DeDiamondPro/AQLARP/README.md

# AQLARP
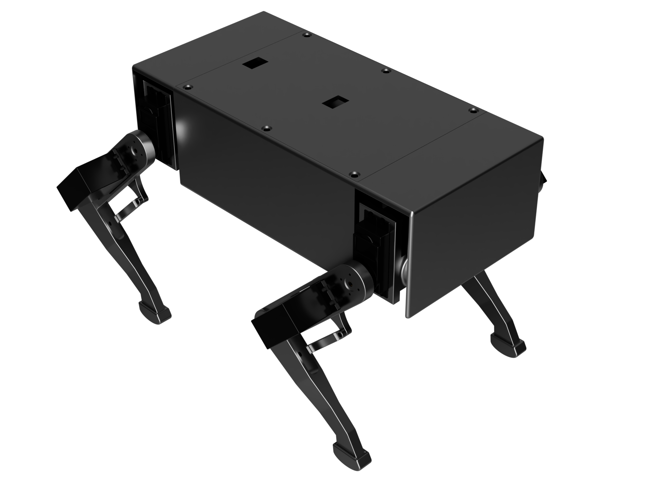
[picture p1: documentation/src/img/AQLARP-render-transparent.png]


AQLARP stands for **A**ffordable **Q**uadruped **L**earning **A**nd **R**esearch **P**latform.

AQLARP was created as my final project for high school.

For more information please see the [documentation](https://aqlarp.dediamondpro.dev)

## AQLARP Walking Demo:

(https://www.youtube.com/watch?v=xvpN8pladkQ)
