DeDiamondPro/AQLARP/documentation/src/ch08-00-inverse-kinematics.md

# Inverse Kinematics
In this chapter we will look at the calculations behind the inverse kinematics of AQLARP. These calculations are based on trigonometry since it is quite easy to split all these problems into triangles.
If you are not familiar with this topic or want more info, I would recommend watching the video below as it does a great job explaining this concept in a simple manner.
<iframe width="560" height="315" src="https://www.youtube-nocookie.com/embed/IN8tjTk8ExI?si=d5JtWDZTZR-PFiA2&amp;start=295" title="YouTube video player" frameborder="0" allow="accelerometer; autoplay; clipboard-write; encrypted-media; gyroscope; picture-in-picture; web-share" allowfullscreen></iframe>
