DeDiamondPro/AQLARP/documentation/src/title-page.md

# AQLARP


Welcome to the AQLARP documentation. This documentation is built with [mdBook](https://github.com/rust-lang/mdBook)

AQLARP stands for **A**ffordable **Q**uadruped **L**earning **A**nd **R**esearch **P**latform.

AQLARP is licensed under the [MIT license](https://github.com/DeDiamondPro/AQLARP/blob/master/LICENSE).

AQLARP was created as my final project for high school.

> **🚨 This documentation might be incomplete**
>
> It is advisable to have a basic understanding of the parts of the robot to effectively address encountered issues. If you need help, feel free to open an issue on [AQLARP's GitHub](https://github.com/DeDiamondPro/AQLARP). However there is no guarantee that I will be able to help you.

<iframe width="560" height="315" src="https://www.youtube-nocookie.com/embed/xvpN8pladkQ?si=OSj0AorqTDjWEt1B" title="YouTube video player" frameborder="0" allow="accelerometer; autoplay; clipboard-write; encrypted-media; gyroscope; picture-in-picture; web-share" allowfullscreen></iframe>
