DeDiamondPro/AQLARP/documentation/src/SUMMARY.md

# AQLARP

[AQLARP](title-page.md)
# Introduction
- [Design Principles](ch01-01-design-principles.md)
- [Coordinate System](ch02-01-coordinate-system.md)
# Building
- [Required Materials](ch03-01-required-materials.md)
- [Raspberry Pi Setup](ch04-01-raspberry-pi-setup.md)
- [Building](ch05-00-building.md)
	- [Building The Legs](ch05-01-building-leg.md)
	- [Building The Main Body](ch05-02-building-body.md)
- [Installing Software](ch06-01-installing-software.md)
# API
- [ROS2 Topics](ch07-01-ros2-topics.md)
# Concepts explained

- [Inverse Kinematics](ch08-00-inverse-kinematics.md)
	- [Inverse Kinematics Of The Legs](ch08-01-inverse-kinematics-legs.md)
	- [Inverse Kinematics Of The Body](ch08-02-inverse-kinematics-body.md)
