DeDiamondPro/AQLARP/documentation/src/ch03-01-required-materials.md

# Required Materials

AQLARP's bill of materials is available [here](https://docs.google.com/spreadsheets/d/e/2PACX-1vRbQA3j36Z8nV3XLGrAlESTOF5qkMQ1r0tQvmaywV8VTpTOwY9WorlNrphstLwu9Ot1-xkpC_Ci4Gyd/pubhtml). ([download](https://docs.google.com/spreadsheets/d/e/2PACX-1vRbQA3j36Z8nV3XLGrAlESTOF5qkMQ1r0tQvmaywV8VTpTOwY9WorlNrphstLwu9Ot1-xkpC_Ci4Gyd/pub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))

<iframe src="https://docs.google.com/spreadsheets/d/e/2PACX-1vRbQA3j36Z8nV3XLGrAlESTOF5qkMQ1r0tQvmaywV8VTpTOwY9WorlNrphstLwu9Ot1-xkpC_Ci4Gyd/pubhtml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", width = 100% height = 560px></iframe>

I would encourage you to look around and see if you can find parts for cheaper since these prices will change with time and depending on your area they may also vary.

Additionally you will have to have the following tools:
- Screw driver for the type of screws you choose
- Soldering iron
- 3D printer
