DeDiamondPro/AQLARP/models/stl/body/Main-Body.stl

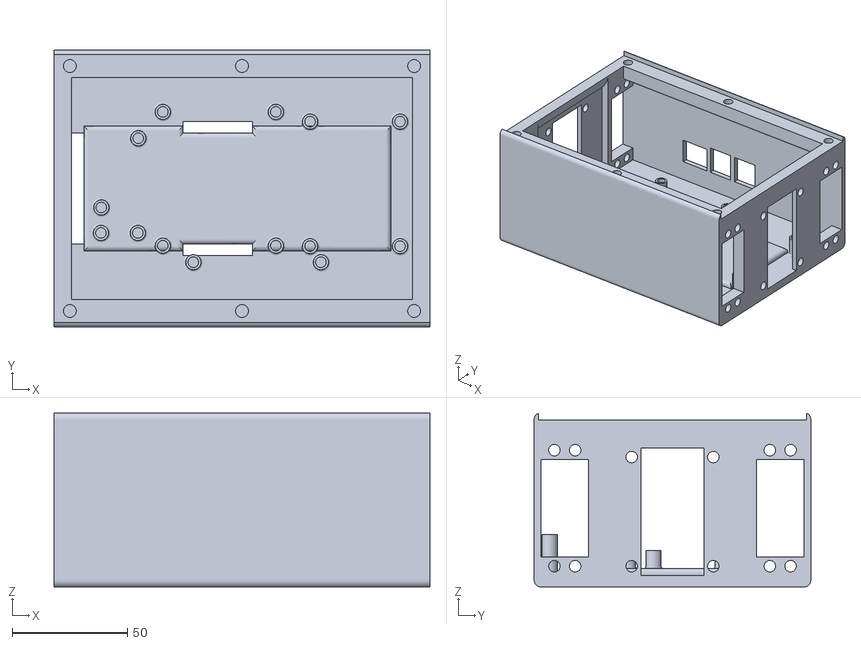
[picture p4: CAD file, 2024-03-20]
models/stl/body/Main-Body.stl
163.0 x 120.0 x 75.4
