DeDiamondPro/AQLARP/models/stl/body/Front-Back-Body.stl

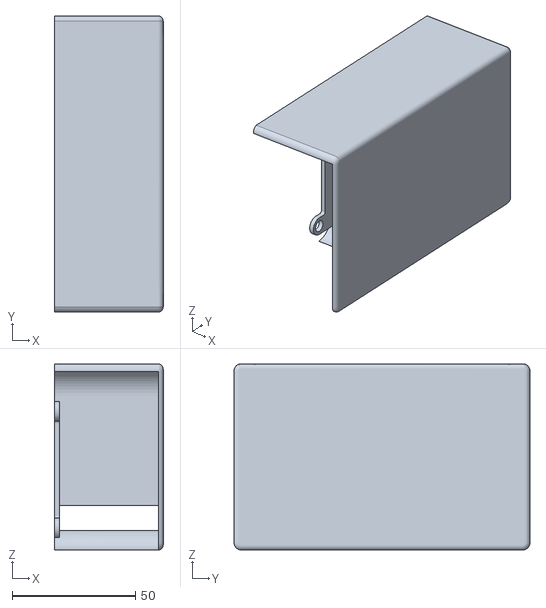
[picture p5: CAD file, 2024-03-20]
models/stl/body/Front-Back-Body.stl
44.0 x 120.0 x 75.4
