DeDiamondPro/AQLARP/models/stl/legs/Sock.stl

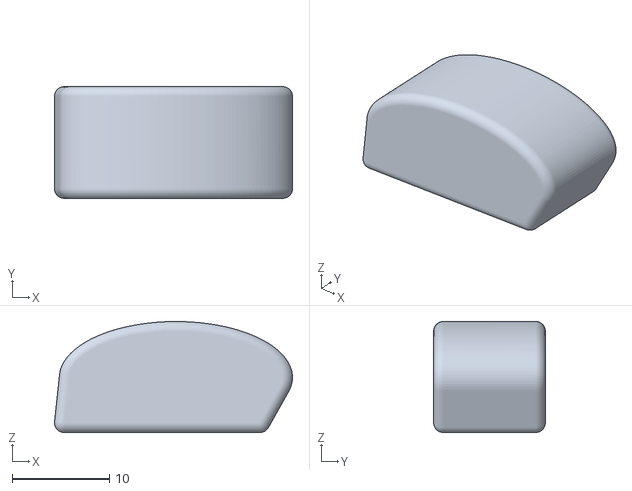
[picture p6: CAD file, 2024-03-20]
models/stl/legs/Sock.stl
24.5 x 11.5 x 11.4
