DeDiamondPro/AQLARP/models/stl/body/Top-Joint-Left.stl

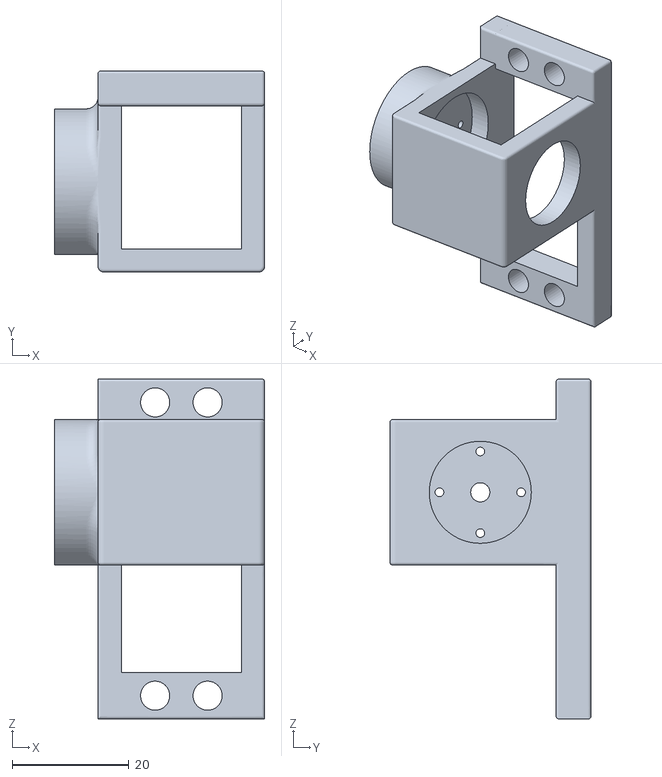
[picture p7: CAD file, 2024-03-20]
models/stl/body/Top-Joint-Left.stl
36.1 x 34.5 x 58.3
