DeDiamondPro/AQLARP/models/stl/legs/Leg-Bottom-Right.stl

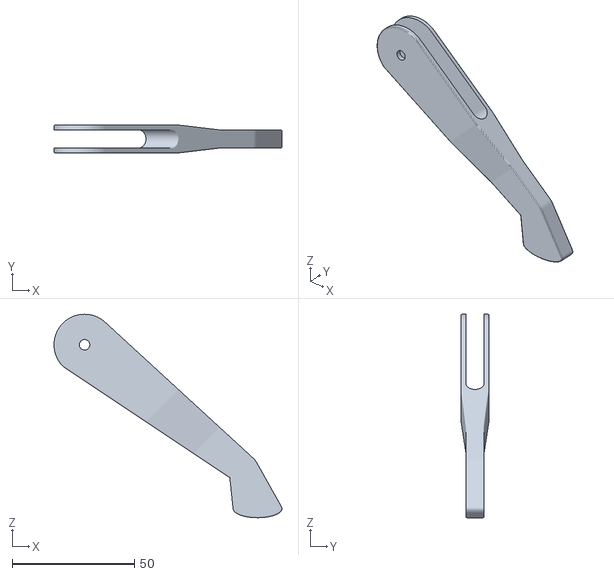
[picture p8: CAD file, 2024-03-20]
models/stl/legs/Leg-Bottom-Right.stl
93.2 x 11.5 x 83.2
