DeDiamondPro/AQLARP/models/stl/legs/Leg-Joint-Bottom-Right.stl

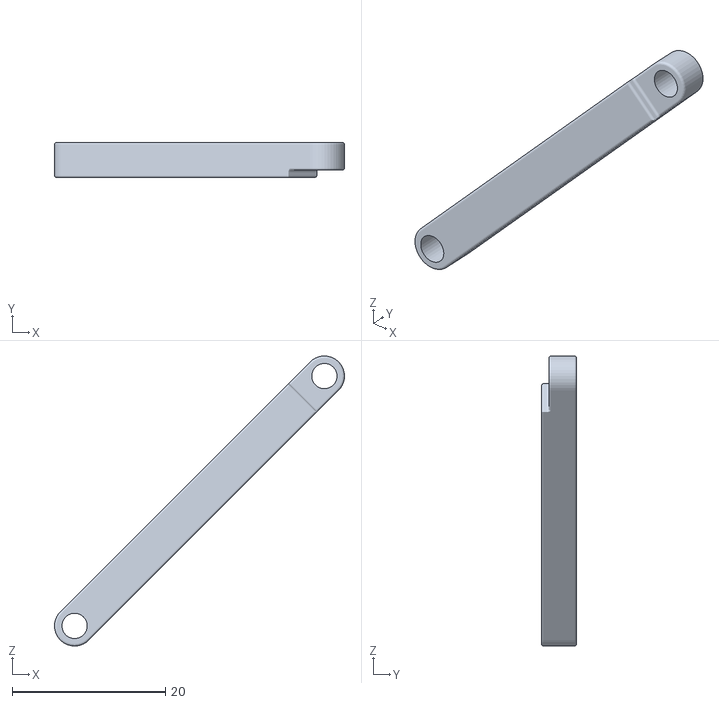
[picture p9: CAD file, 2024-03-20]
models/stl/legs/Leg-Joint-Bottom-Right.stl
37.9 x 4.62 x 37.9
