DeDiamondPro/AQLARP/models/stl/body/Top-Cover.stl

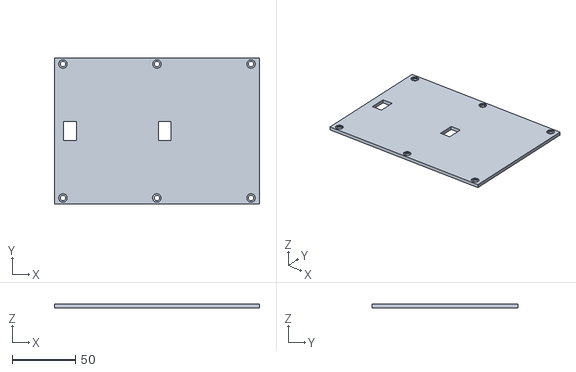
[picture p10: CAD file, 2024-03-20]
models/stl/body/Top-Cover.stl
162.6 x 115.6 x 3.00
