DeDiamondPro/AQLARP/models/stl/legs/Leg-Joint-Top-Right.stl

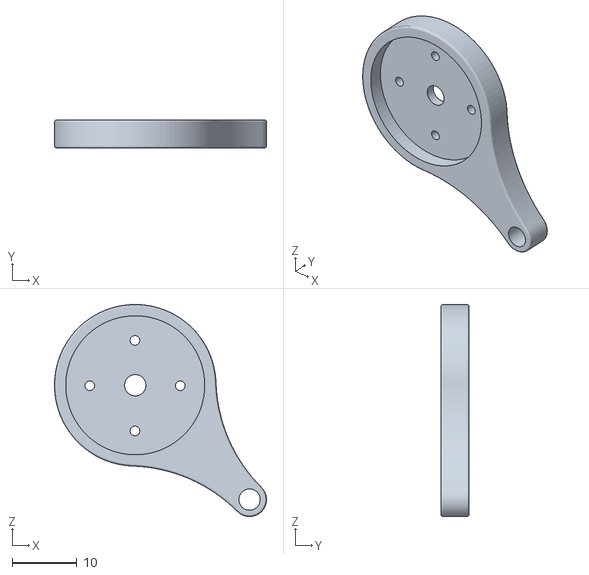
[picture p11: CAD file, 2024-03-20]
models/stl/legs/Leg-Joint-Top-Right.stl
32.8 x 4.38 x 32.8
