DeDiamondPro/AQLARP/models/stl/legs/Leg-Top-Right.stl

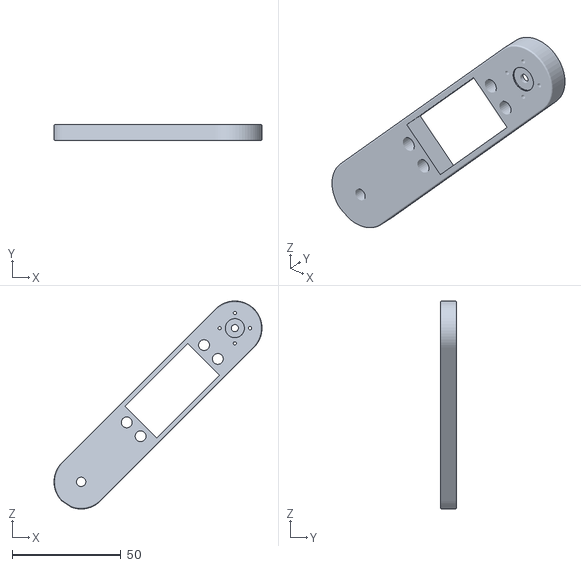
[picture p12: CAD file, 2024-03-20]
models/stl/legs/Leg-Top-Right.stl
95.7 x 7.50 x 95.7
