DeDiamondPro/AQLARP/models/stl/misc/Nut-Tool.stl

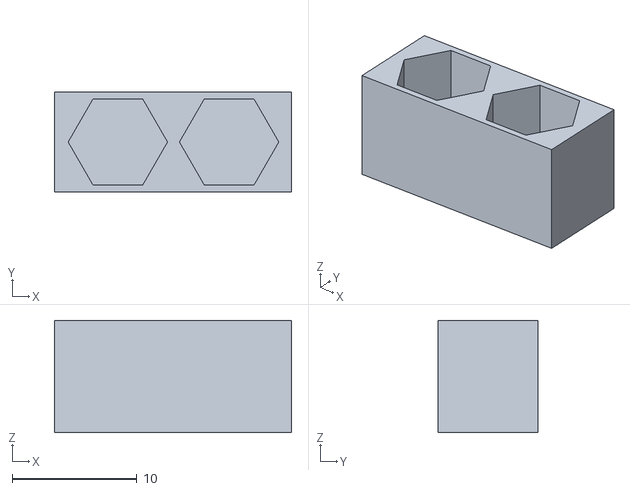
[picture p13: CAD file, 2024-03-20]
models/stl/misc/Nut-Tool.stl
19.0 x 8.00 x 9.00
