DeDiamondPro/AQLARP/(list of files, cad)

Other CAD files:
models/stl/body/Top-Joint-Right.stl
models/stl/legs/Leg-Top-Left.stl
models/stl/legs/Leg-Joint-Bottom-Left.stl
models/stl/legs/Leg-Joint-Top-Left.stl
models/stl/legs/Leg-Bottom-Left.stl
