DeDiamondPro/AQLARP/documentation/src/img/PCA_gryo_wiring.png

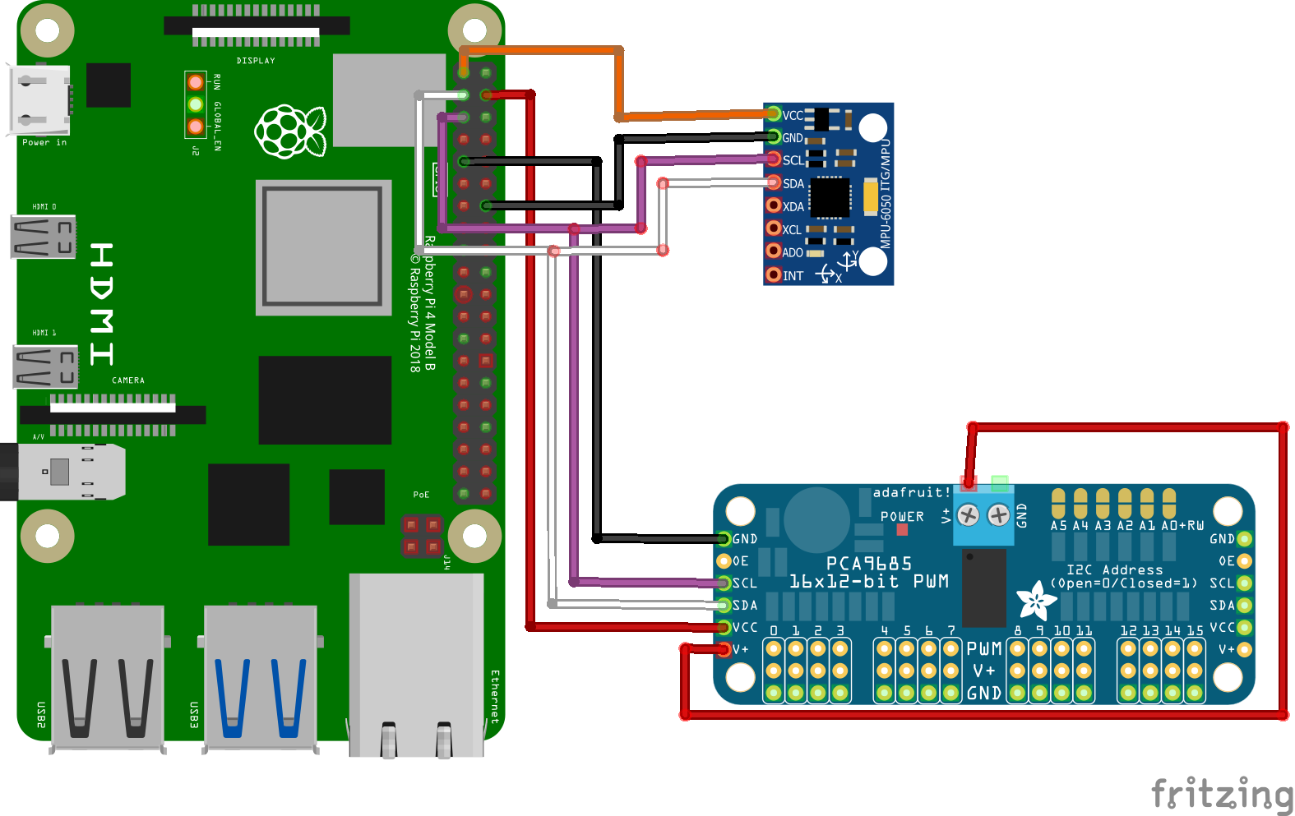
documentation/src/img/PCA_gryo_wiring.png
